JQTemp/gfet-readout-board/images/v2_bottom.png

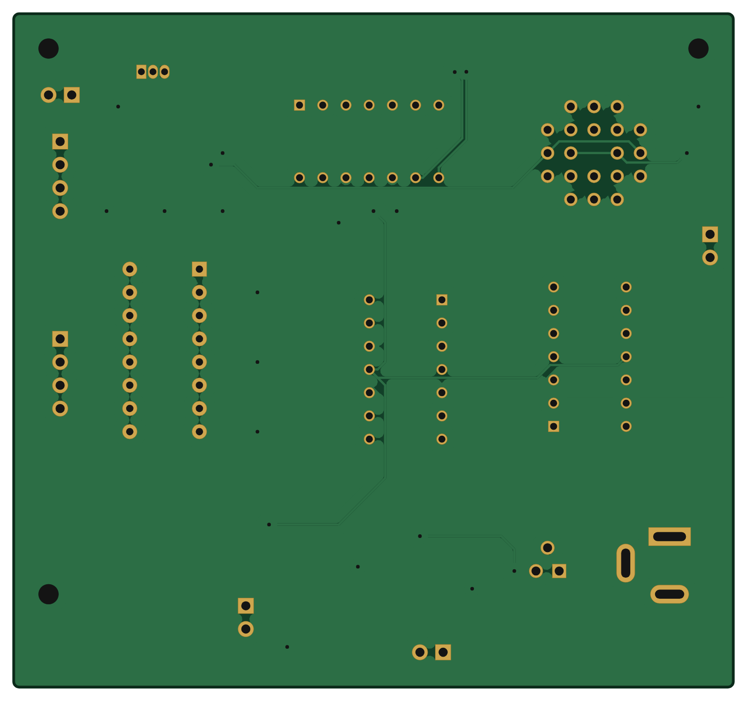
images/v2_bottom.png
