JQTemp/gfet-readout-board/mechanical/sensusv1 v9 bottom.stl

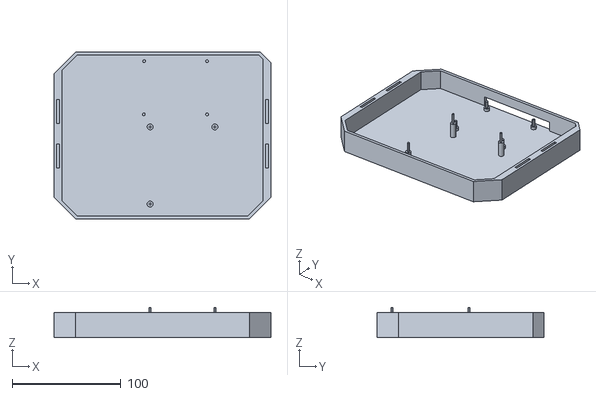
[picture p9: CAD file, 2026-11-01]
mechanical/sensusv1 v9 bottom.stl
200.0 x 154.0 x 28.0
