JQTemp/gfet-readout-board/mechanical/sensusv1 v8 top_part1.stl

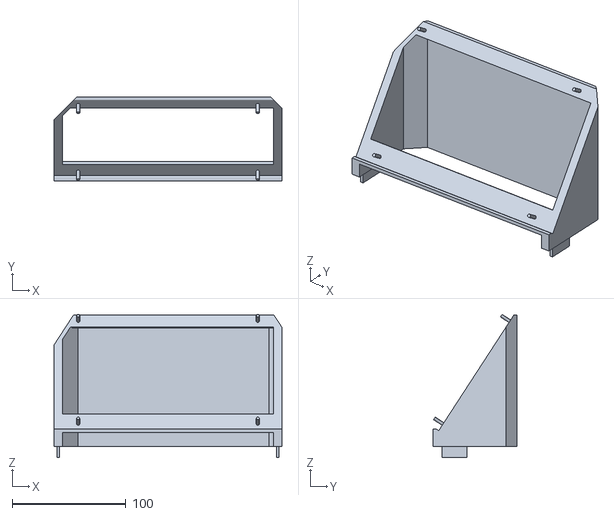
[picture p10: CAD file, 2026-11-01]
mechanical/sensusv1 v8 top_part1.stl
200.0 x 74.0 x 125.7
