JQTemp/gfet-readout-board/mechanical/sensusv1 v8 top_part2.stl

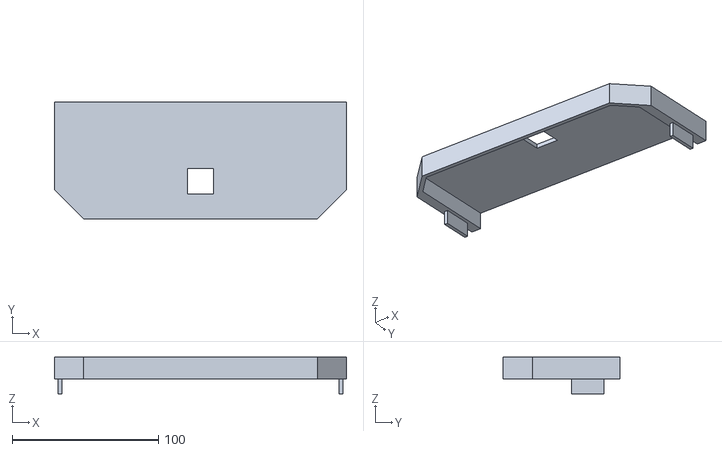
[picture p11: CAD file, 2026-11-01]
mechanical/sensusv1 v8 top_part2.stl
200.0 x 80.0 x 25.0
