JQTemp/gfet-readout-board/hardware/v2/gfet-readout-v2.kicad_pcb

## KiCad design hardware/v2/gfet-readout-v2.kicad_pcb (2026-11-01)

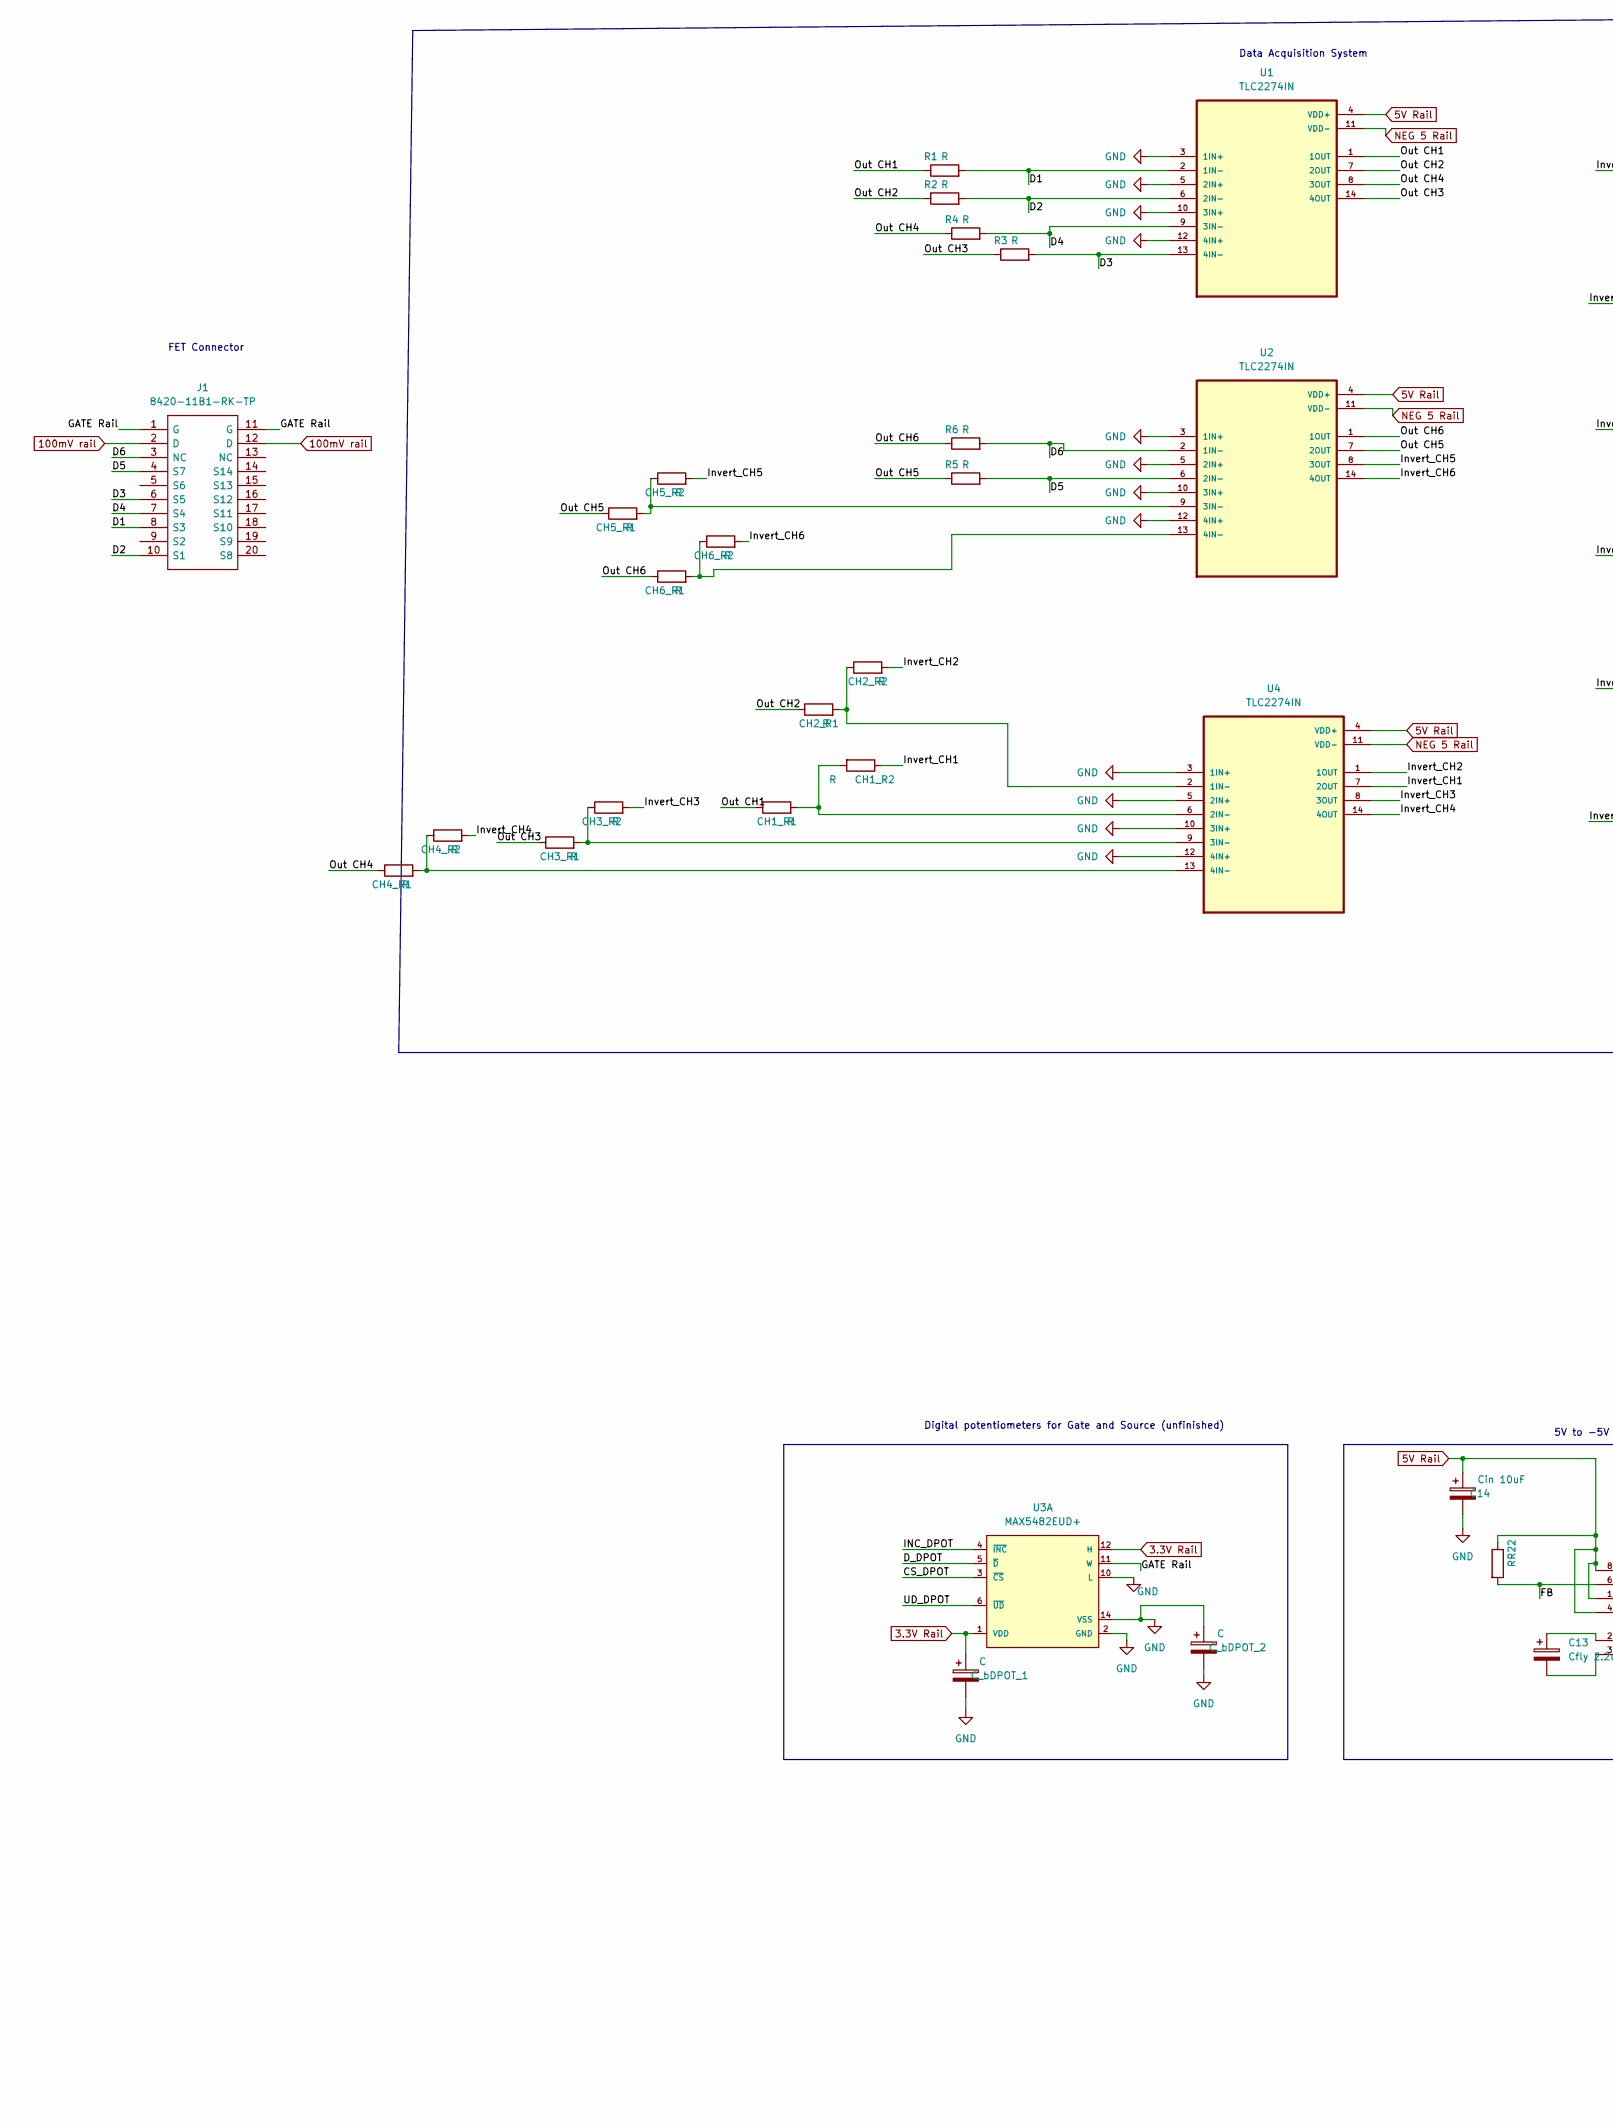
[picture p12: schematic gfet-readout-v2.kicad_sch, part in row 1, column 1]

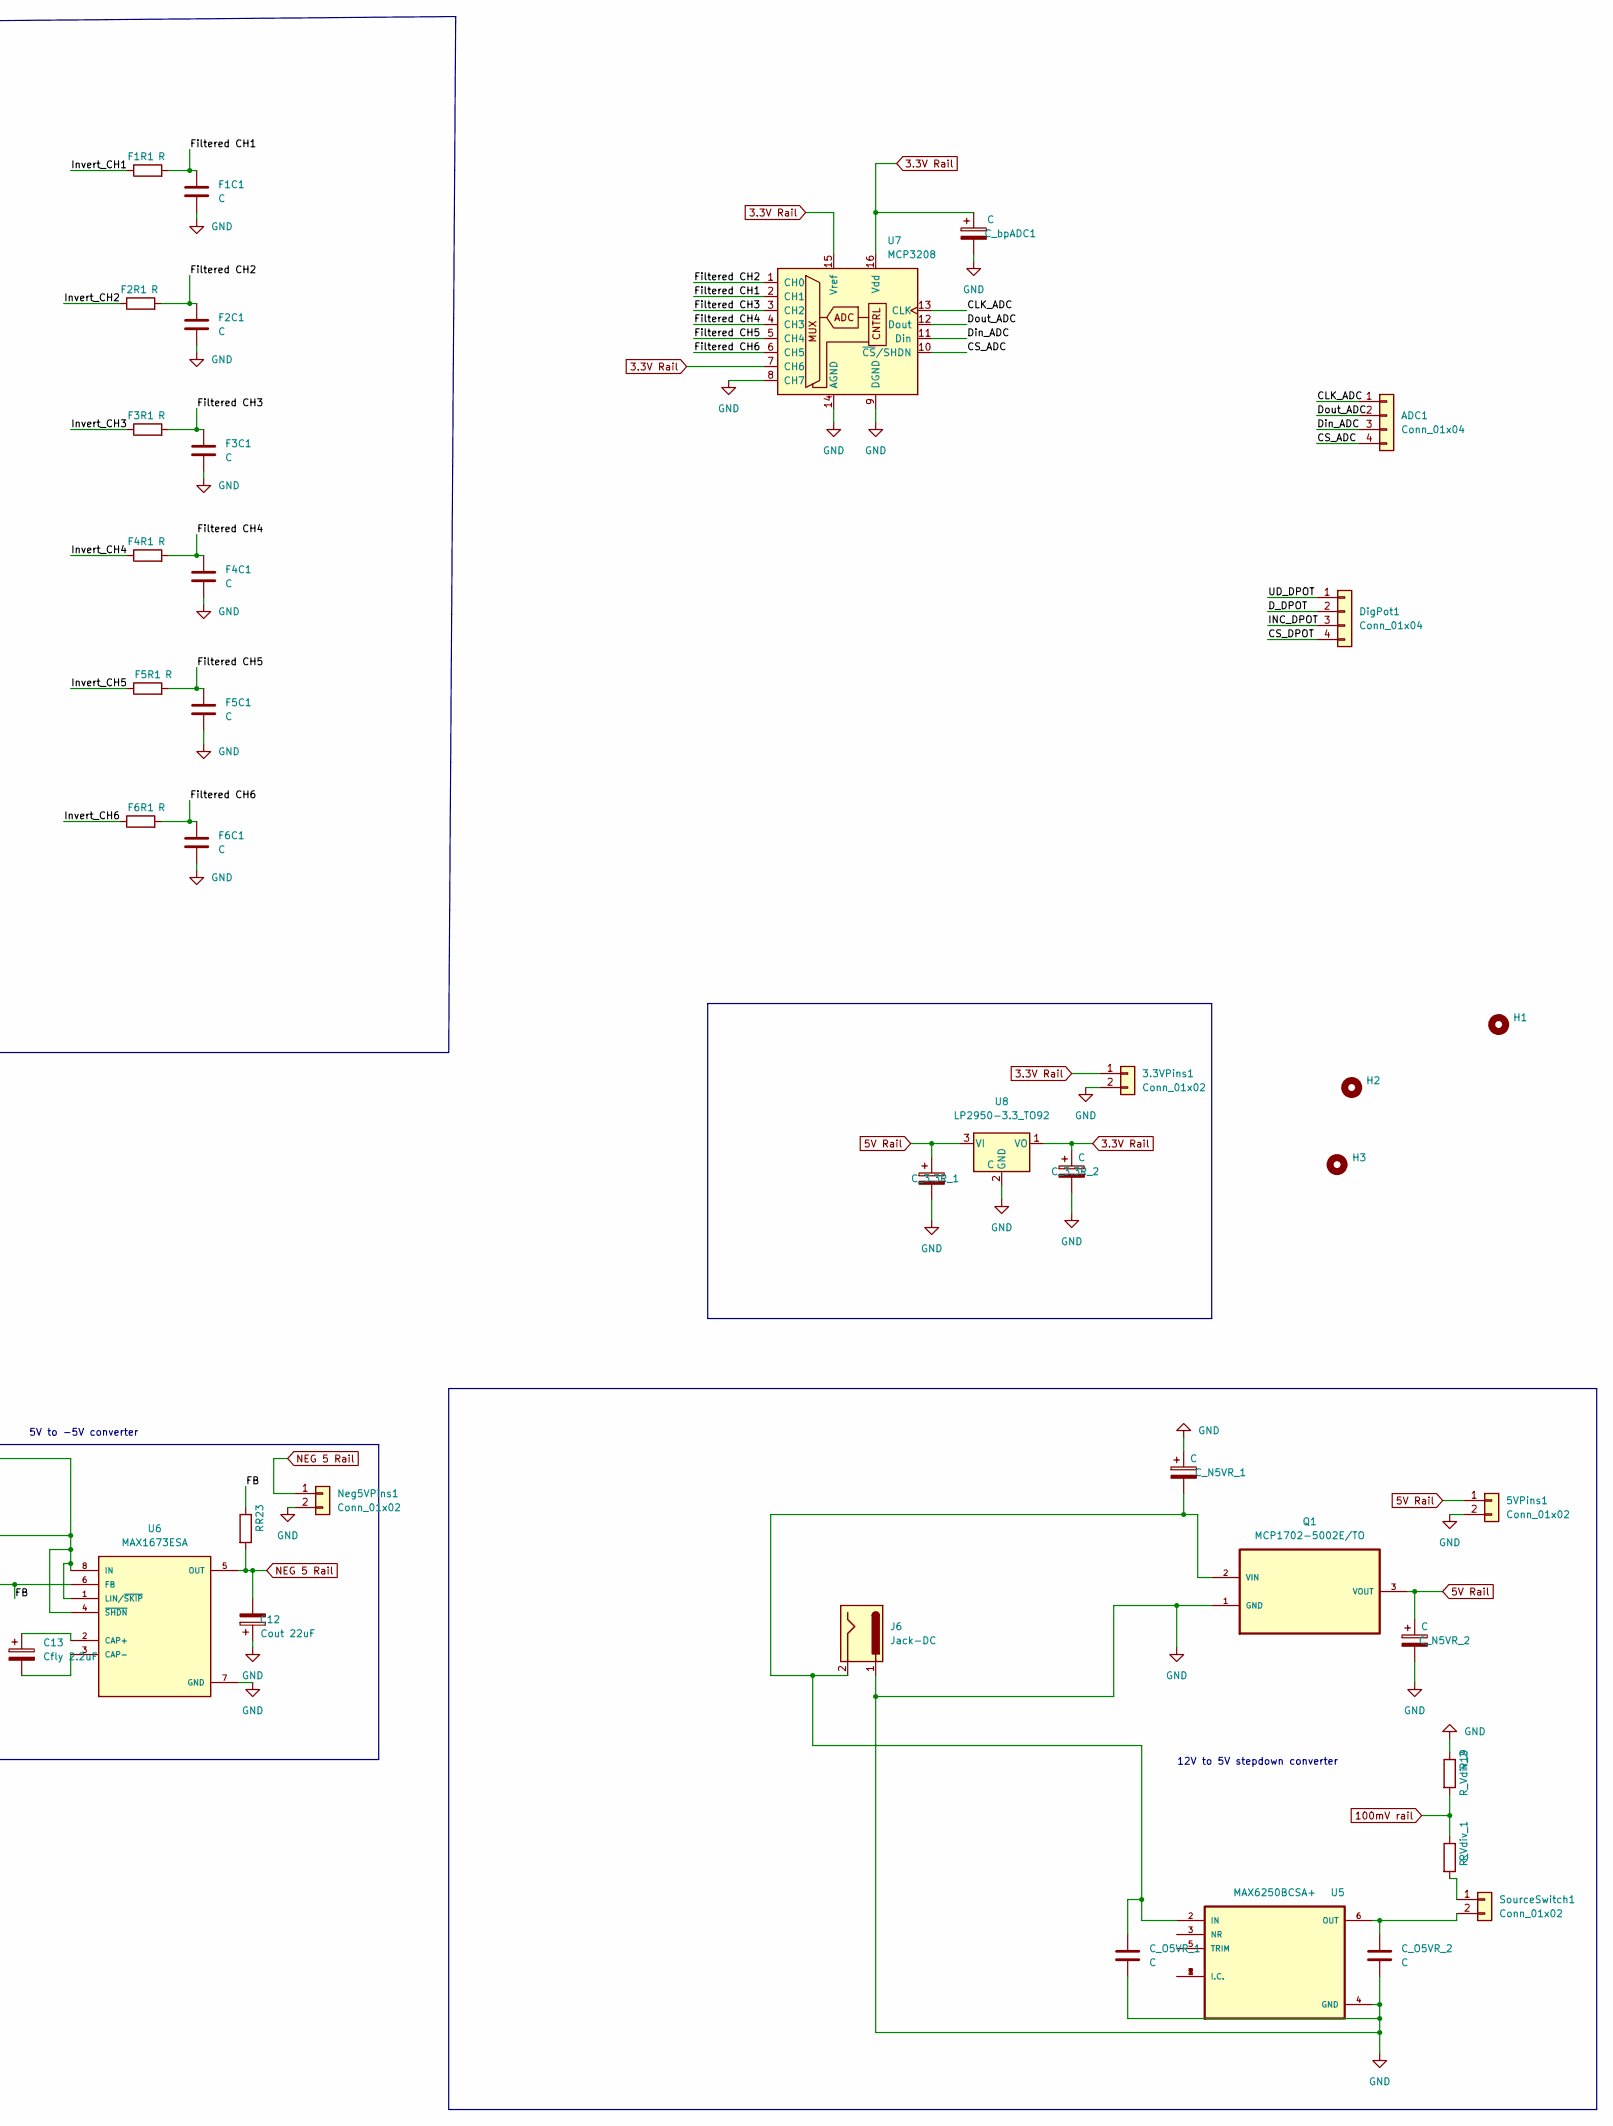
[picture p13: schematic gfet-readout-v2.kicad_sch, part in row 1, column 2]

Parts:
3.3VPins1, 5VPins1: Conn_01x02; PinHeader_1x02_P2.54mm_Vertical
ADC1: Conn_01x04; PinHeader_1x04_P2.54mm_Vertical
C12: Cout 22uF; C_1206_3216Metric_Pad1.33x1.80mm_HandSolder
C13: Cfly 2.2uF; C_0603_1608Metric_Pad1.08x0.95mm_HandSolder
C14: Cin 10uF; C_0805_2012Metric_Pad1.18x1.45mm_HandSolder
CH1_R1, CH1_R2, CH2_R1, CH2_R2, CH3_R1, CH3_R2, CH4_R1, CH4_R2, CH5_R1, CH5_R2, CH6_R1, CH6_R2: R; R_0805_2012Metric_Pad1.20x1.40mm_HandSolder
C_3.3R_1, C_3.3R_2: C; C_0805_2012Metric_Pad1.18x1.45mm_HandSolder
C_N5VR_1, C_N5VR_2: C; C_0805_2012Metric_Pad1.18x1.45mm_HandSolder
C_O5VR_1, C_O5VR_2: C; C_0603_1608Metric_Pad1.08x0.95mm_HandSolder
C_bDPOT_1, C_bDPOT_2: C; C_0805_2012Metric_Pad1.18x1.45mm_HandSolder
C_bpADC1: C; C_0805_2012Metric_Pad1.18x1.45mm_HandSolder
DigPot1: Conn_01x04; PinHeader_1x04_P2.54mm_Vertical
F1C1, F2C1, F3C1, F4C1, F5C1, F6C1: C; C_0805_2012Metric_Pad1.18x1.45mm_HandSolder
F1R1, F2R1, F3R1, F4R1, F5R1, F6R1: R; R_0805_2012Metric_Pad1.20x1.40mm_HandSolder
H1, H2, H3: MountingHole_2.2mm_M2
J1: 8420-11B1-RK-TP; 842011B1RKTP; Mouser Part Number 517-8420-11B1-RK-TP
J6: Jack-DC; BarrelJack_GCT_DCJ200-10-A_Horizontal
Neg5VPins1: Conn_01x02; PinHeader_1x02_P2.54mm_Vertical
Q1: MCP1702-5002E/TO; TO127P254X533-3; MPN MCP1702-5002E/TO
R1, R2, R3, R4, R5, R6, R22, R23: R; R_0805_2012Metric_Pad1.20x1.40mm_HandSolder
R19: R_Vdiv_2; R_0805_2012Metric_Pad1.20x1.40mm_HandSolder
R_Vdiv_1: R; R_0805_2012Metric_Pad1.20x1.40mm_HandSolder
SourceSwitch1: Conn_01x02; PinHeader_1x02_P2.54mm_Vertical
U1, U2, U4: TLC2274IN; DIP794W45P254L1969H508Q14
U3: MAX5482EUD+; Maxim-MAX5481EUD+-Level_B
U5: MAX6250BCSA+; SOIC127P600X175-8N
U6: MAX1673ESA; SOIC127P600X175-8N; PARTREV 0
U7: MCP3208; DIP-16_W7.62mm
U8: LP2950-3.3_TO92; TO-92_Inline

Connections:
3.3V Rail: 3.3VPins1.1, C_3.3R_2.1, C_bDPOT_1.1, C_bpADC1.1, U3.1 (VDD), U3.12 (H), U7.7 (CH6), U7.15 (Vref), U7.16 (Vdd), U8.1 (VO)
5V Rail: 5VPins1.1, C14.1, C_3.3R_1.1, C_N5VR_2.1, Q1.3 (VOUT), R22.1, U1.4 (VDD+), U2.4 (VDD+), U4.4 (VDD+), U6.1 (LIN/~SKIP), U6.4 (~SHDN), U6.8 (IN), U8.3 (VI)
100mV rail: J1.2 (D), J1.12 (D), R19.2, R_Vdiv_1.1
/CLK_ADC: ADC1.1, U7.13 (CLK)
/CS_ADC: ADC1.4, U7.10 (~CS/SHDN)
/CS_DPOT: DigPot1.4, U3.3 (~CS)
/D1: J1.8 (S3), R1.2, U1.2 (1IN-)
/D2: J1.10 (S1), R2.2, U1.6 (2IN-)
/D3: J1.6 (S5), R3.2, U1.13 (4IN-)
/D4: J1.7 (S4), R4.2, U1.9 (3IN-)
/D5: J1.4 (S7), R5.2, U2.6 (2IN-)
/D6: J1.3 (NC), R6.2, U2.2 (1IN-)
/D_DPOT: DigPot1.2, U3.5 (~D)
/Din_ADC: ADC1.3, U7.11 (Din)
/Dout_ADC: ADC1.2, U7.12 (Dout)
/FB: R22.2, R23.1, U6.6 (FB)
/Filtered CH1: F1C1.1, F1R1.2, U7.2 (CH1)
/Filtered CH2: F2C1.1, F2R1.2, U7.1 (CH0)
/Filtered CH3: F3C1.1, F3R1.2, U7.3 (CH2)
/Filtered CH4: F4C1.1, F4R1.2, U7.4 (CH3)
/Filtered CH5: F5C1.1, F5R1.2, U7.5 (CH4)
/Filtered CH6: F6C1.1, F6R1.2, U7.6 (CH5)
/GATE Rail: J1.1 (G), J1.11 (G), U3.11 (W)
/INC_DPOT: DigPot1.3, U3.4 (~INC)
/Invert_CH1: CH1_R2.1, F1R1.1, U4.7 (2OUT)
/Invert_CH2: CH2_R2.2, F2R1.1, U4.1 (1OUT)
/Invert_CH3: CH3_R2.2, F3R1.1, U4.8 (3OUT)
/Invert_CH4: CH4_R2.2, F4R1.1, U4.14 (4OUT)
/Invert_CH5: CH5_R2.2, F5R1.1, U2.8 (3OUT)
/Invert_CH6: CH6_R2.2, F6R1.1, U2.14 (4OUT)
/Out CH1: CH1_R1.1, R1.1, U1.1 (1OUT)
/Out CH2: CH2_R1.1, R2.1, U1.7 (2OUT)
/Out CH3: CH3_R1.1, R3.1, U1.14 (4OUT)
/Out CH4: CH4_R1.1, R4.1, U1.8 (3OUT)
/Out CH5: CH5_R1.1, R5.1, U2.7 (2OUT)
/Out CH6: CH6_R1.1, R6.1, U2.1 (1OUT)
/UD_DPOT: DigPot1.1, U3.6 (~UD)
GND: 3.3VPins1.2, 5VPins1.2, C12.1, C14.2, C_3.3R_1.2, C_3.3R_2.2, C_N5VR_1.1, C_N5VR_2.2, C_O5VR_1.2, C_O5VR_2.2, C_bDPOT_1.2, C_bDPOT_2.1, C_bDPOT_2.2, C_bpADC1.2, F1C1.2, F2C1.2, F3C1.2, F4C1.2, F5C1.2, F6C1.2, J6.1, Neg5VPins1.2, Q1.1 (GND), R19.1, U1.3 (1IN+), U1.5 (2IN+), U1.10 (3IN+), U1.12 (4IN+), U2.3 (1IN+), U2.5 (2IN+), U2.10 (3IN+), U2.12 (4IN+), U3.2 (GND), U3.10 (L), U3.14 (VSS), U4.3 (1IN+), U4.5 (2IN+), U4.10 (3IN+), U4.12 (4IN+), U5.4 (GND), U6.7 (GND), U7.8 (CH7), U7.9 (DGND), U7.14 (AGND), U8.2 (GND)
NEG 5 Rail: C12.2, Neg5VPins1.1, R23.2, U1.11 (VDD-), U2.11 (VDD-), U4.11 (VDD-), U6.5 (OUT)
unnamed: C13.1, U6.2 (CAP+)
unnamed: C13.2, U6.3 (CAP-)
unnamed: CH1_R1.2, CH1_R2.2, U4.6 (2IN-)
unnamed: CH3_R1.2, CH3_R2.1, U4.9 (3IN-)
unnamed: CH4_R1.2, CH4_R2.1, U4.13 (4IN-)
unnamed: CH5_R1.2, CH5_R2.1, U2.9 (3IN-)
unnamed: CH6_R1.2, CH6_R2.1, U2.13 (4IN-)
unnamed: C_N5VR_1.2, C_O5VR_1.1, J6.2, Q1.2 (VIN), U5.2 (IN)
unnamed 47: R_Vdiv_1.2, SourceSwitch1.1; also elsewhere on the board
unnamed: CH2_R1.2, CH2_R2.1, U4.2 (1IN-)
unnamed: U5.1 (I.C.), U5.7 (I.C.), U5.8 (I.C.)
unnamed 50: C_O5VR_2.1, SourceSwitch1.2, U5.6 (OUT); also elsewhere on the board

Notes on the sheet:
Digital potentiometers for Gate and Source (unfinished)
FET Connector
5V to -5V converter
12V to 5V stepdown converter
Data Acquisition System

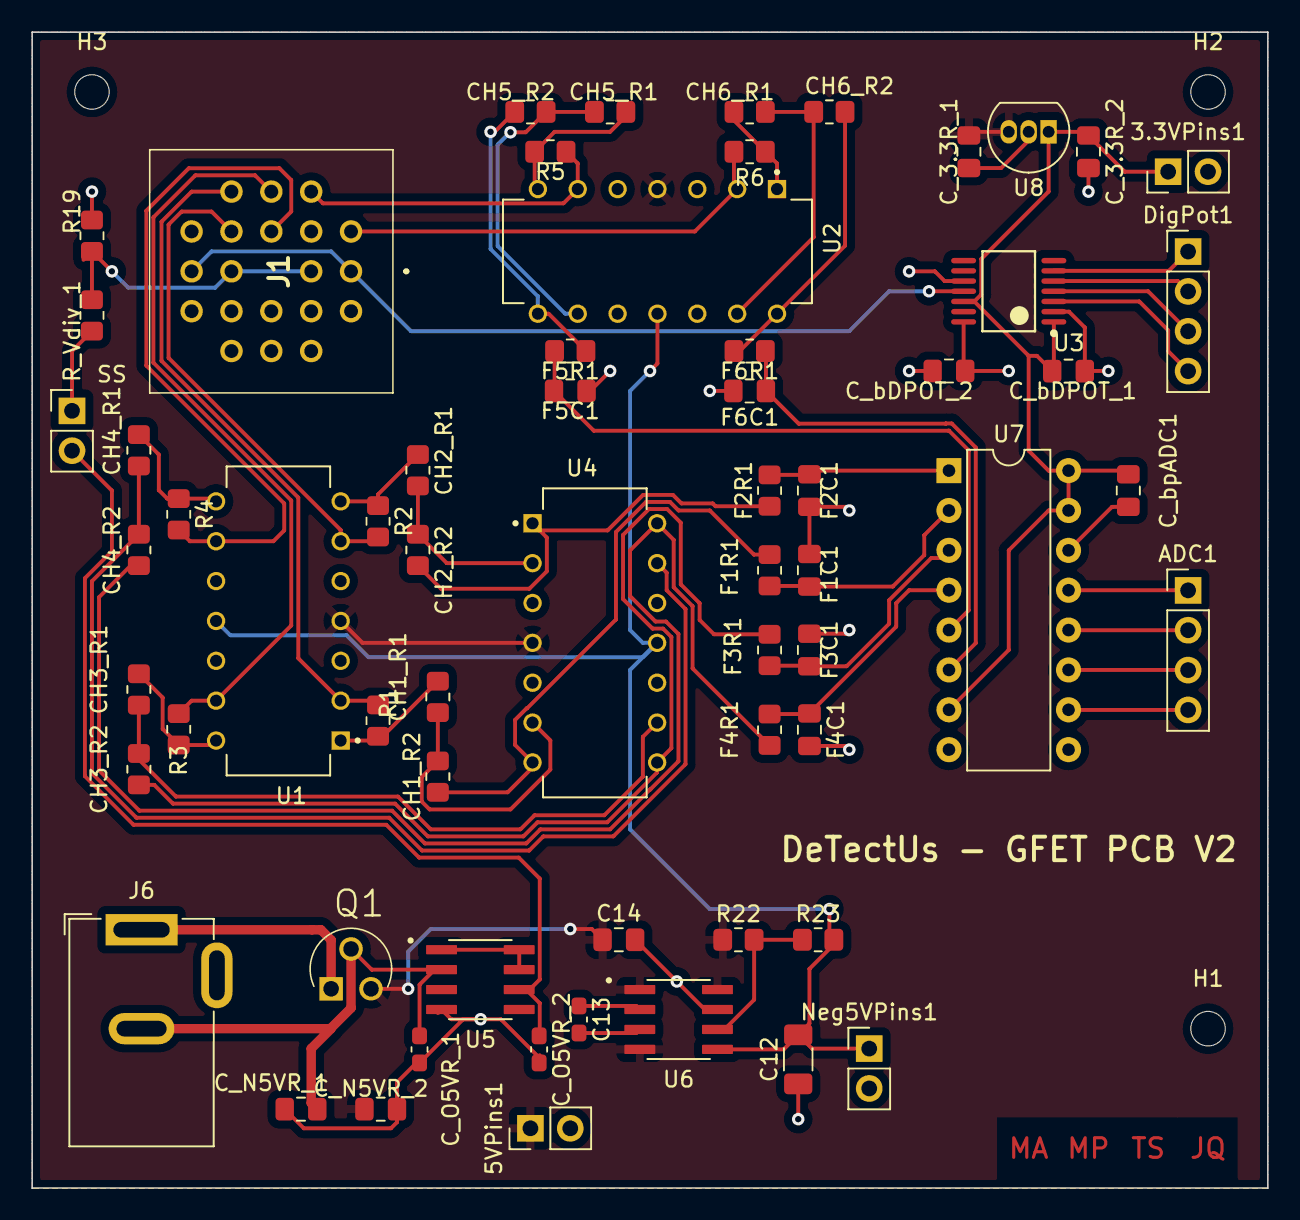
[picture p14: board gfet-readout-v2.kicad_pcb from above]

Board: 2 copper layers, 78.7 x 73.7 mm, 66 parts (0 on the bottom side), 51 nets.

Other parts of the board:
SS: Conn_01x02; PinHeader_1x02_P2.54mm_Vertical

Their connections:
unnamed 47: SS.1; also elsewhere on the board
unnamed 50: SS.2; also elsewhere on the board
