JQTemp/gfet-readout-board/hardware/v1/gfet-readout-v1.kicad_pcb

## KiCad design hardware/v1/gfet-readout-v1.kicad_pcb (2026-11-01, an earlier design)

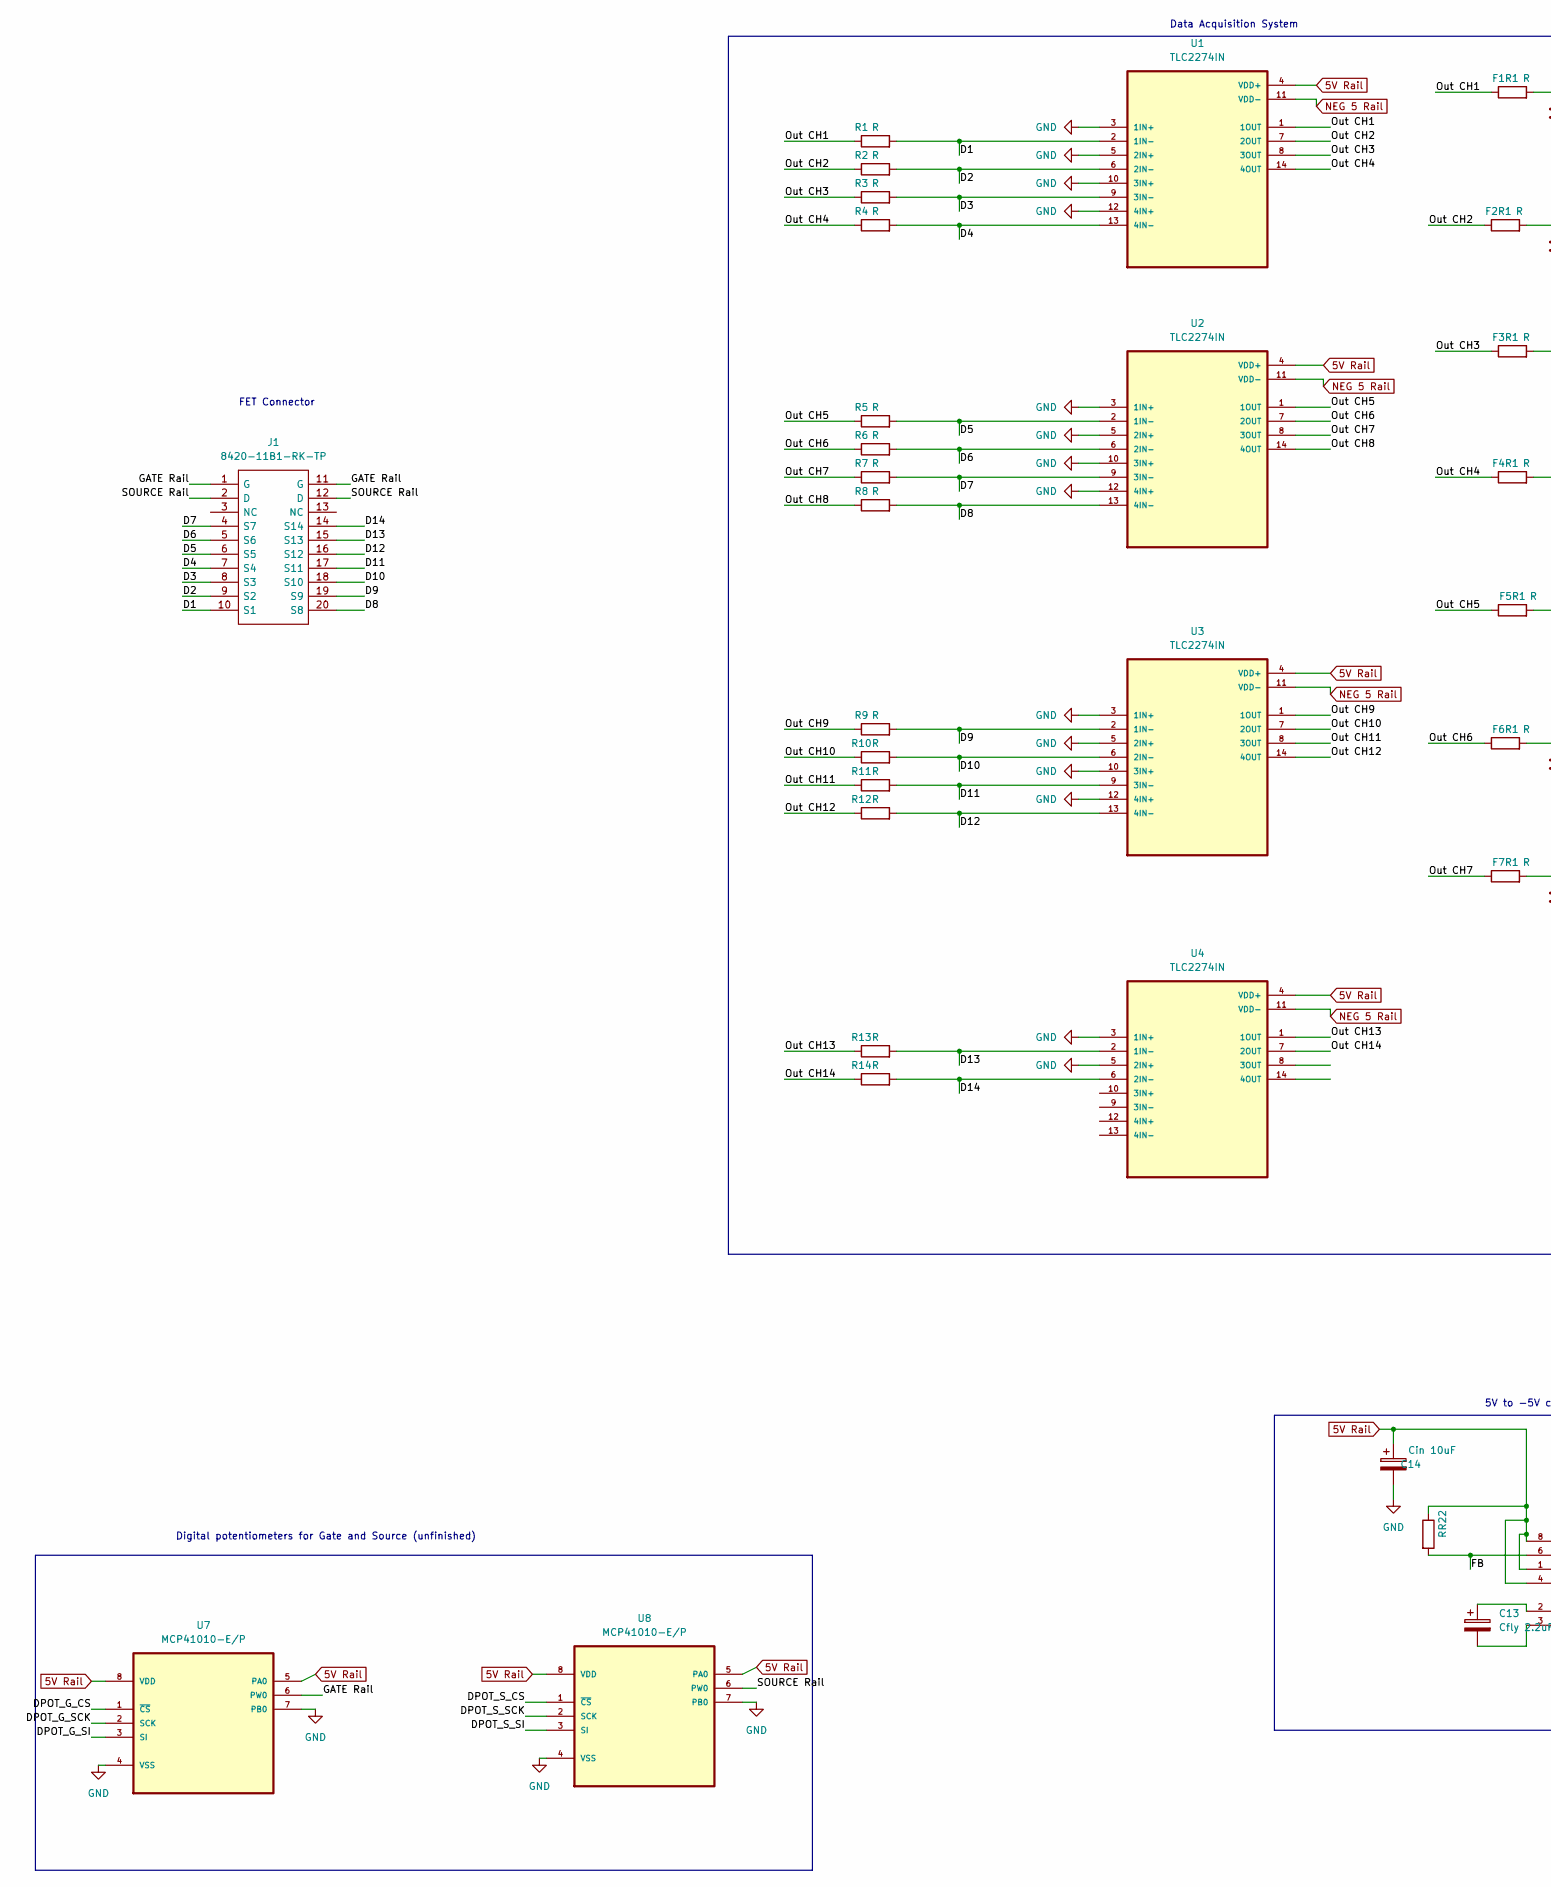
[picture p15: schematic gfet-readout-v1.kicad_sch, part in row 1, column 1]

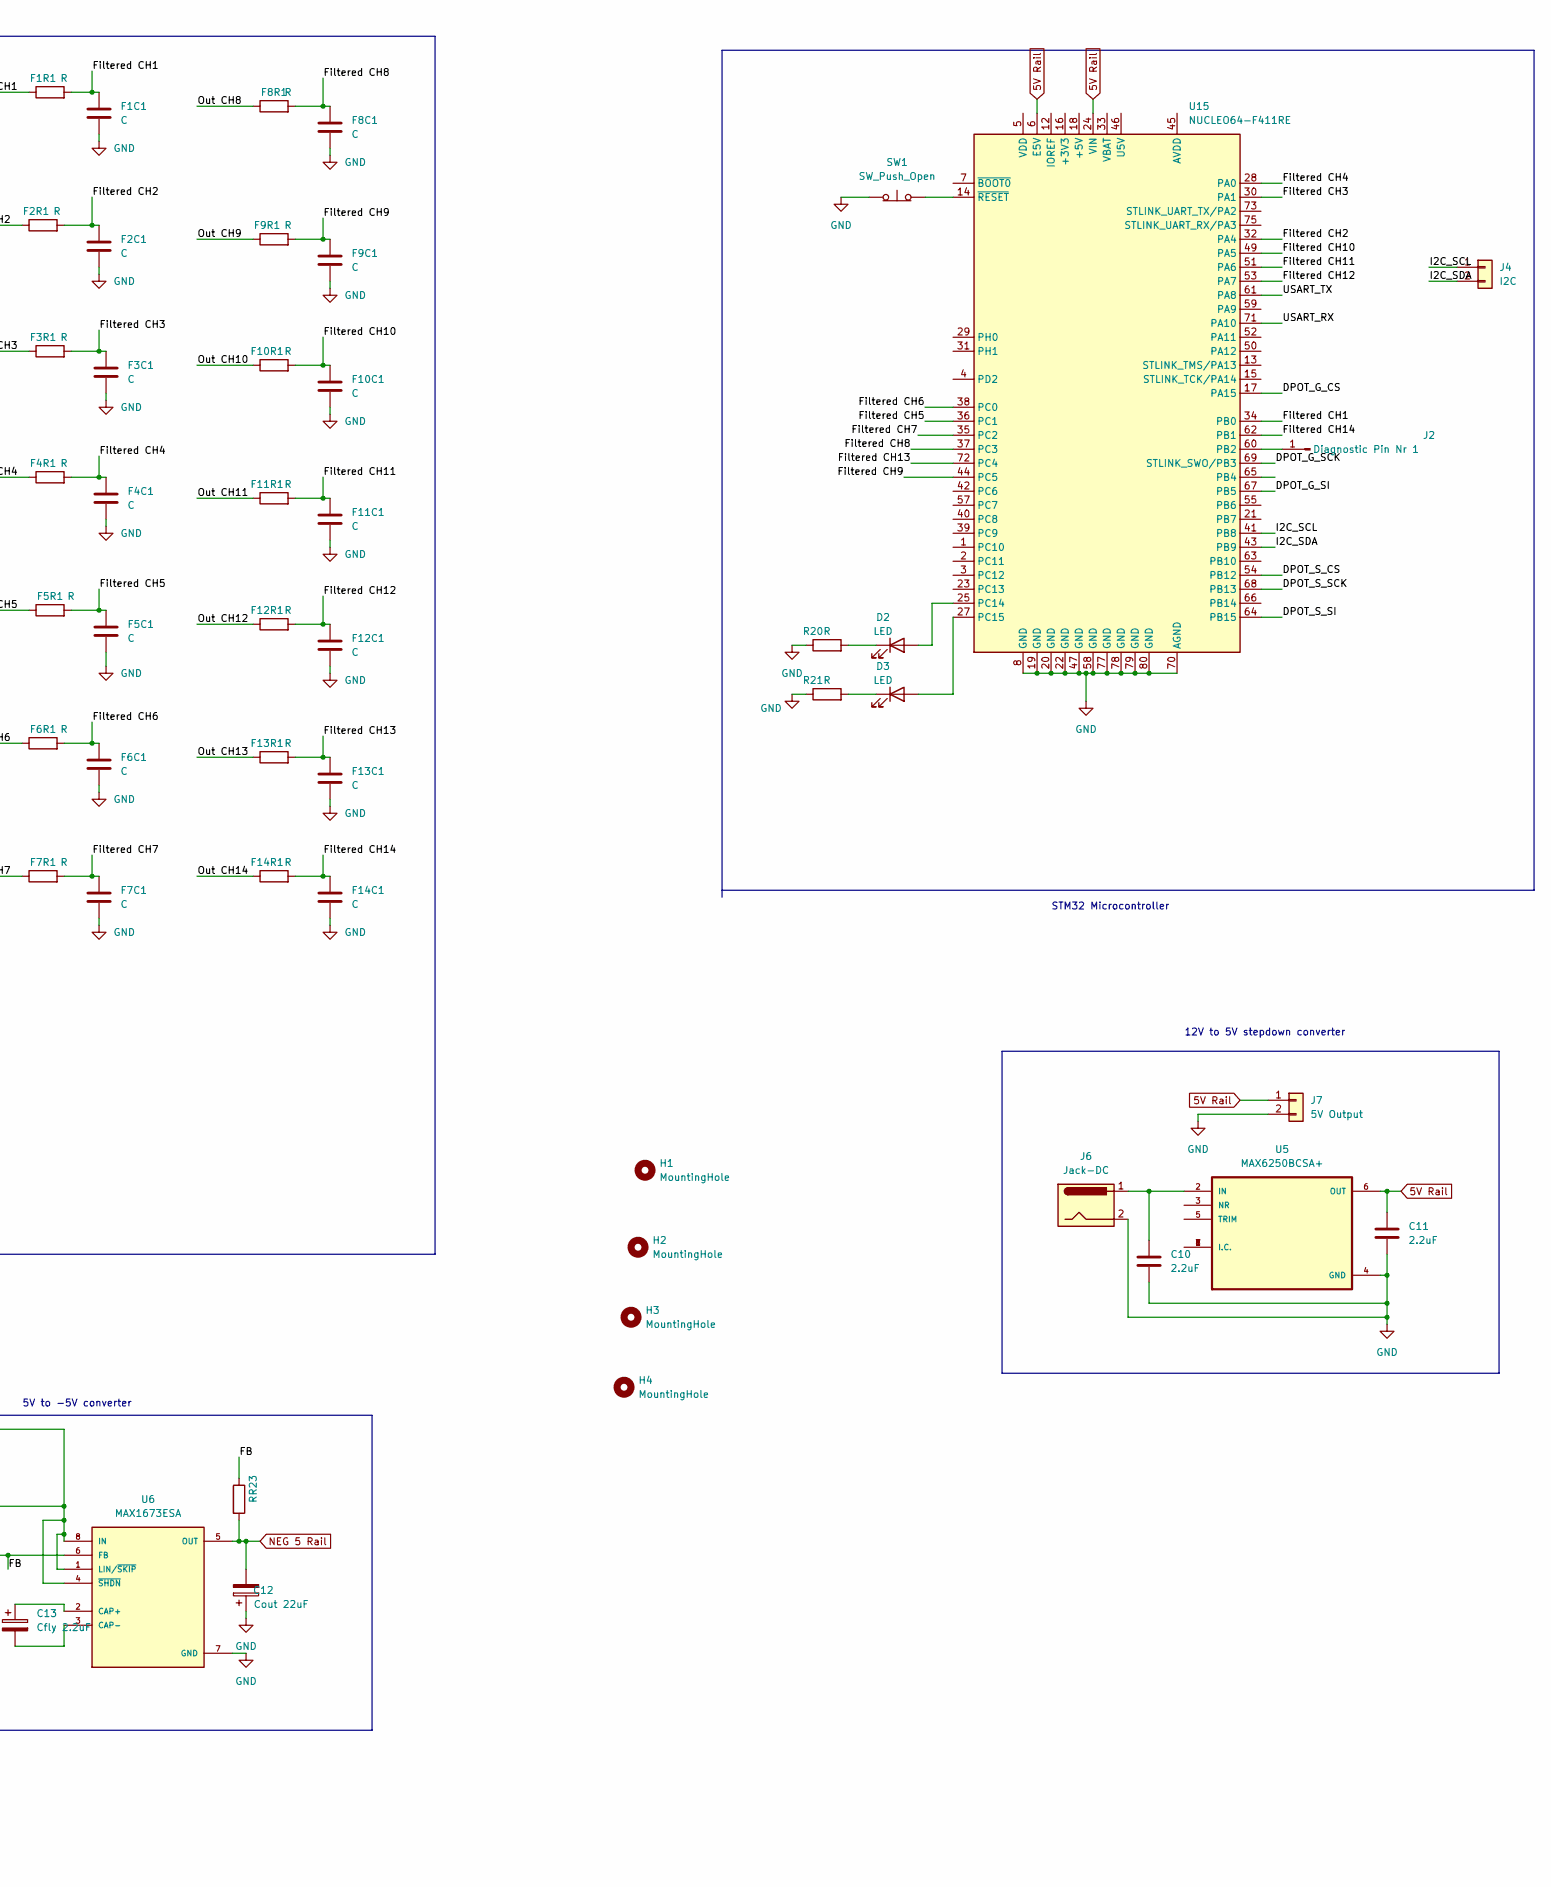
[picture p16: schematic gfet-readout-v1.kicad_sch, part in row 1, column 2]

Parts:
C10, C11: 2.2uF; C_0603_1608Metric_Pad1.08x0.95mm_HandSolder
C12: Cout 22uF; C_1206_3216Metric_Pad1.33x1.80mm_HandSolder
C13: Cfly 2.2uF; C_0603_1608Metric_Pad1.08x0.95mm_HandSolder
C14: Cin 10uF; C_0805_2012Metric_Pad1.18x1.45mm_HandSolder
D2, D3: LED; LED_D5.0mm
F1C1, F2C1, F3C1, F4C1, F5C1, F6C1, F7C1, F8C1, F9C1, F10C1, F11C1, F12C1, F13C1, F14C1: C; C_0805_2012Metric_Pad1.18x1.45mm_HandSolder
F1R1, F2R1, F3R1, F4R1, F5R1, F6R1, F7R1, F8R1, F9R1, F10R1, F11R1, F12R1, F13R1, F14R1: R; R_0805_2012Metric_Pad1.20x1.40mm_HandSolder
H1, H2, H3, H4: MountingHole; MountingHole_4.3mm_M4
J1: 8420-11B1-RK-TP; 842011B1RKTP; Mouser Part Number 517-8420-11B1-RK-TP
J2: Diagnostic Pin Nr 1; Pin_D0.9mm_L10.0mm_W2.4mm_FlatFork
J4: I2C; PinHeader_1x02_P2.54mm_Vertical
J6: Jack-DC; BarrelJack_GCT_DCJ200-10-A_Horizontal
J7: 5V Output; PinHeader_1x02_P2.54mm_Vertical
R1, R2, R3, R4, R5, R6, R7, R8, R9, R10, R11, R12, R13, R14, R20, R21, R22, R23: R; R_0805_2012Metric_Pad1.20x1.40mm_HandSolder
SW1: SW_Push_Open; SW_PUSH_6mm
U1, U2, U3, U4: TLC2274IN; DIP794W45P254L1969H508Q14
U5: MAX6250BCSA+; SOIC127P600X175-8N
U6: MAX1673ESA; SOIC127P600X175-8N; PARTREV 0
U7, U8: MCP41010-E/P; DIP254P762X432-8; MPN MCP41010-E/P
U15: NUCLEO64-F411RE; ST_Morpho_Connector_144_STLink

Connections:
5V Rail: C11.1, C14.1, J7.1, R22.1, U1.4 (VDD+), U2.4 (VDD+), U3.4 (VDD+), U4.4 (VDD+), U5.6 (OUT), U6.1 (LIN/~SKIP), U6.4 (~SHDN), U6.8 (IN), U7.5 (PA0), U7.8 (VDD), U8.5 (PA0), U8.8 (VDD), U15.6 (E5V), U15.24 (VIN)
/D1: J1.10 (S1), R1.2, U1.2 (1IN-)
/D2: J1.9 (S2), R2.2, U1.6 (2IN-)
/D3: J1.8 (S3), R3.2, U1.9 (3IN-)
/D4: J1.7 (S4), R4.2, U1.13 (4IN-)
/D5: J1.6 (S5), R5.2, U2.2 (1IN-)
/D6: J1.5 (S6), R6.2, U2.6 (2IN-)
/D7: J1.4 (S7), R7.2, U2.9 (3IN-)
/D8: J1.20 (S8), R8.2, U2.13 (4IN-)
/D9: J1.19 (S9), R9.2, U3.2 (1IN-)
/D10: J1.18 (S10), R10.2, U3.6 (2IN-)
/D11: J1.17 (S11), R11.2, U3.9 (3IN-)
/D12: J1.16 (S12), R12.2, U3.13 (4IN-)
/D13: J1.15 (S13), R13.2, U4.2 (1IN-)
/D14: J1.14 (S14), R14.2, U4.6 (2IN-)
/DPOT_G_CS: U7.1 (~CS), U15.17 (PA15)
/DPOT_G_SCK: U7.2 (SCK), U15.69 (STLINK_SWO/PB3)
/DPOT_G_SI: U7.3 (SI), U15.67 (PB5)
/DPOT_S_CS: U8.1 (~CS), U15.54 (PB12)
/DPOT_S_SCK: U8.2 (SCK), U15.68 (PB13)
/DPOT_S_SI: U8.3 (SI), U15.64 (PB15)
/FB: R22.2, R23.1, U6.6 (FB)
/Filtered CH1: F1C1.1, F1R1.2, U15.34 (PB0)
/Filtered CH2: F2C1.1, F2R1.2, U15.32 (PA4)
/Filtered CH3: F3C1.1, F3R1.2, U15.30 (PA1)
/Filtered CH4: F4C1.1, F4R1.2, U15.28 (PA0)
/Filtered CH5: F5C1.1, F5R1.2, U15.36 (PC1)
/Filtered CH6: F6C1.1, F6R1.2, U15.38 (PC0)
/Filtered CH7: F7C1.1, F7R1.2, U15.35 (PC2)
/Filtered CH8: F8C1.1, F8R1.2, U15.37 (PC3)
/Filtered CH9: F9C1.1, F9R1.2, U15.44 (PC5)
/Filtered CH10: F10C1.1, F10R1.2, U15.49 (PA5)
/Filtered CH11: F11C1.1, F11R1.2, U15.51 (PA6)
/Filtered CH12: F12C1.1, F12R1.2, U15.53 (PA7)
/Filtered CH13: F13C1.1, F13R1.2, U15.72 (PC4)
/Filtered CH14: F14C1.1, F14R1.2, U15.62 (PB1)
/GATE Rail: J1.1 (G), J1.11 (G), U7.6 (PW0)
/I2C_SCL: J4.1, U15.41 (PB8)
/I2C_SDA: J4.2, U15.43 (PB9)
/Out CH1: F1R1.1, R1.1, U1.1 (1OUT)
/Out CH2: F2R1.1, R2.1, U1.7 (2OUT)
/Out CH3: F3R1.1, R3.1, U1.8 (3OUT)
/Out CH4: F4R1.1, R4.1, U1.14 (4OUT)
/Out CH5: F5R1.1, R5.1, U2.1 (1OUT)
/Out CH6: F6R1.1, R6.1, U2.7 (2OUT)
/Out CH7: F7R1.1, R7.1, U2.8 (3OUT)
/Out CH8: F8R1.1, R8.1, U2.14 (4OUT)
/Out CH9: F9R1.1, R9.1, U3.1 (1OUT)
/Out CH10: F10R1.1, R10.1, U3.7 (2OUT)
/Out CH11: F11R1.1, R11.1, U3.8 (3OUT)
/Out CH12: F12R1.1, R12.1, U3.14 (4OUT)
/Out CH13: F13R1.1, R13.1, U4.1 (1OUT)
/Out CH14: F14R1.1, R14.1, U4.7 (2OUT)
/SOURCE Rail: J1.2 (D), J1.12 (D), U8.6 (PW0)
/USART_RX: U15.71 (PA10)
/USART_TX: U15.61 (PA8)
GND: C10.2, C11.2, C12.1, C14.2, F1C1.2, F2C1.2, F3C1.2, F4C1.2, F5C1.2, F6C1.2, F7C1.2, F8C1.2, F9C1.2, F10C1.2, F11C1.2, F12C1.2, F13C1.2, F14C1.2, J6.2, J7.2, R20.1, R21.1, SW1.1 (A), U1.3 (1IN+), U1.5 (2IN+), U1.10 (3IN+), U1.12 (4IN+), U2.3 (1IN+), U2.5 (2IN+), U2.10 (3IN+), U2.12 (4IN+), U3.3 (1IN+), U3.5 (2IN+), U3.10 (3IN+), U3.12 (4IN+), U4.3 (1IN+), U4.5 (2IN+), U5.4 (GND), U6.7 (GND), U7.4 (VSS), U7.7 (PB0), U8.4 (VSS), U8.7 (PB0), U15.8 (GND), U15.19 (GND), U15.20 (GND), U15.22 (GND), U15.47 (GND), U15.58 (GND), U15.70 (AGND), U15.77 (GND), U15.78 (GND), U15.79 (GND), U15.80 (GND)
NEG 5 Rail: C12.2, R23.2, U1.11 (VDD-), U2.11 (VDD-), U3.11 (VDD-), U4.11 (VDD-), U6.5 (OUT)
unnamed: C10.1, J6.1, U5.2 (IN)
unnamed: C13.1, U6.2 (CAP+)
unnamed: C13.2, U6.3 (CAP-)
unnamed: D2.1 (K), R20.2
unnamed: D2.2 (A), U15.25 (PC14)
unnamed: D3.1 (K), R21.2
unnamed: D3.2 (A), U15.27 (PC15)
unnamed: J2.1, U15.60 (PB2)
unnamed: SW1.2 (B), U15.14 (~RESET)
unnamed: U5.1 (I.C.), U5.7 (I.C.), U5.8 (I.C.)

Notes on the sheet:
STM32 Microcontroller
Digital potentiometers for Gate and Source (unfinished)
FET Connector
5V to -5V converter
12V to 5V stepdown converter
Data Acquisition System

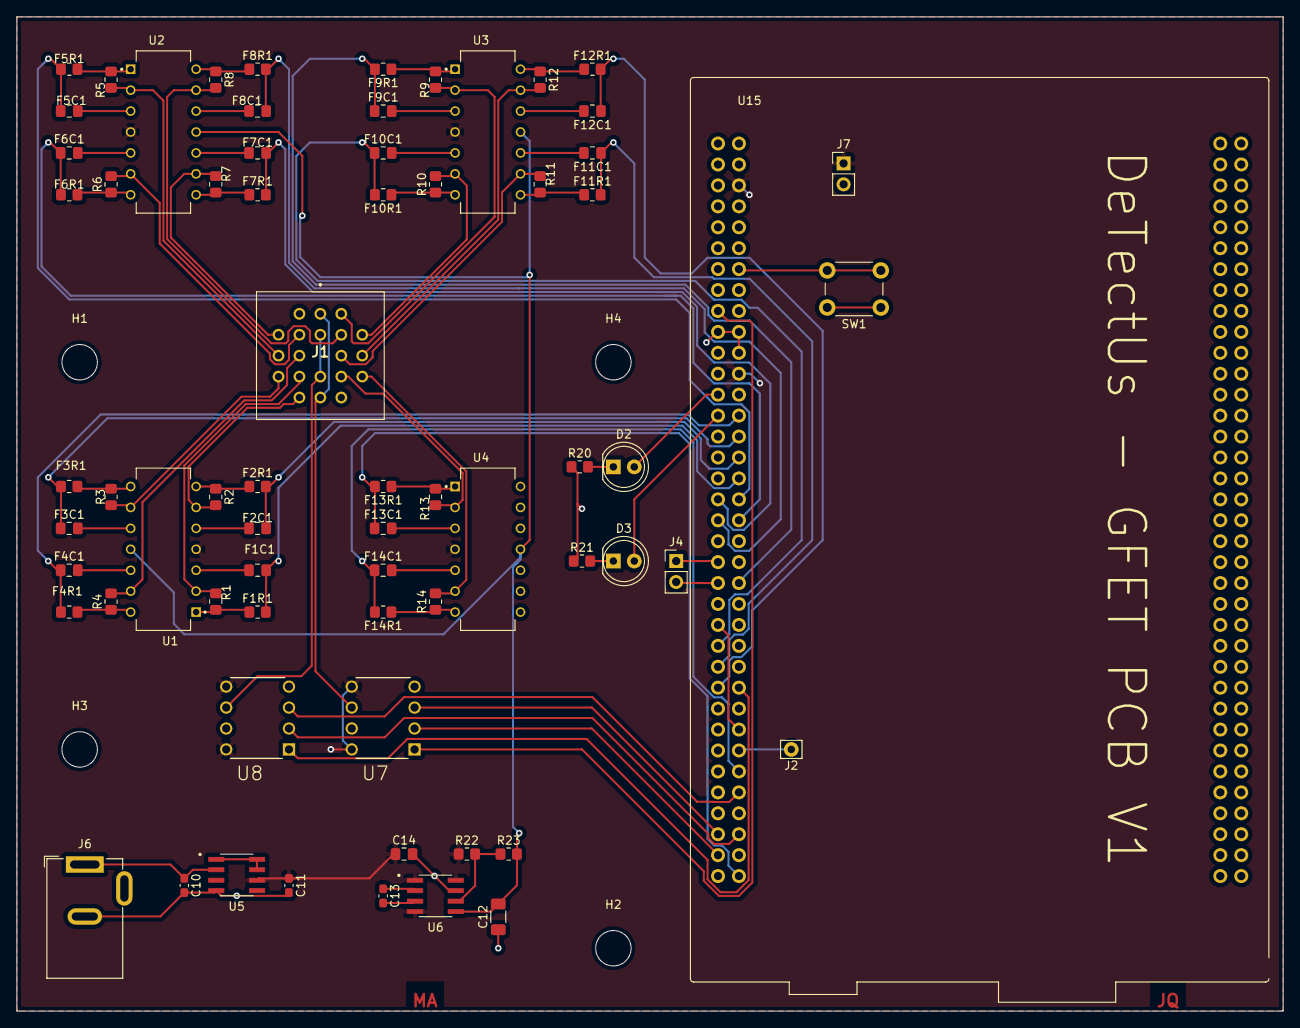
[picture p17: board gfet-readout-v1.kicad_pcb from above]

Board: 2 copper layers, 153.7 x 120.7 mm, 72 parts (0 on the bottom side), 66 nets.
